eSpark-Backup/elliotrosenberg-oildiffuser/README.md

# Oil Diffuser Hardware Design
#### Client Name: Elliot Rosenberg

## Project Requirements
The project is essentially a hardware design for an Oil Diffuser product. Two variants of the design are required. The core features are highlighted below:
### Design Variant 01
- A circle with a maximum diameter of 5” with space on the inside for the atomizer disc. Placement should be followed as shown in image below
- The board should have 3 small holes for attachment to the body. See picture attached for clarification. Dia will be compatible with M2 screws.
- 24V input jack DC Barrel Input Jack.
- Circuit power controlled by a binary switch. ON should turn ON the following:
    - A small DC fan.
    - An ultrasonic atomizer and associated circuitry.
 
#### Reference Product Image


### Design Variant 02
- A circle with a maximum diameter of 4” with space on the inside for the atomizer disc.
- Rest of all requirements same as Variant 01.

### Additional Notes
- Original PRD pushed to docs folder
- Some reference links and resources are shared below as received:
    - [Ultrasonic Mist Maker](https://www.amazon.com/MEETOOT-2-Pack-Ultrasonic-Ceramics-Sealing/dp/B09L7KBF53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)
    - [Atomization Film Air Humidifier Driver Board](https://www.amazon.com/Atomization-Humidifier-Driver-Ultrasonic-Circuit/dp/B0BX6CV5P3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)
    - [ON/OFF Binary Switch](https://www.amazon.com/Gardner-Bender-GSW-18-Heavy-Duty-Electrical/dp/B00004WLKC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)
    - [DC Centrifugal Fan](https://www.amazon.com/Wathai-Brushless-Cooling-Turbo-Blower/dp/B07RP14KML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)
