eSpark-Backup/elliotrosenberg-oildiffuser/Design Files/Oil-Diffuser-A-v1.0.0/Deliverables/Renderings/3D-Bottom.png

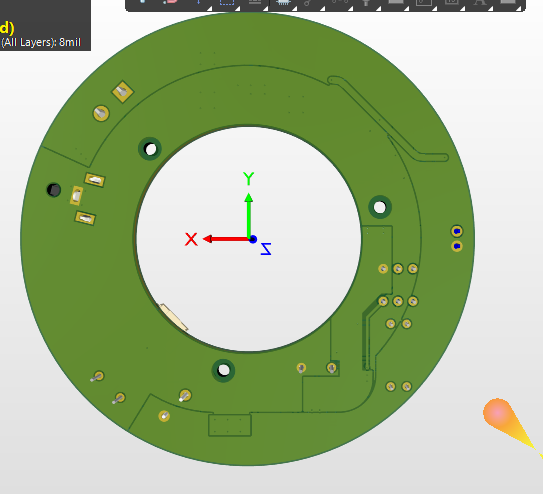
Design Files/Oil-Diffuser-A-v1.0.0/Deliverables/Renderings/3D-Bottom.png
