eSpark-Backup/elliotrosenberg-oildiffuser/Design Files/Oil-Diffuser-A-v1.0.0/BOM/Client-BOM-Oil-Diffuser-A-v1.0.0.xlsx

# | Item Type | Designator | Description | Footprint | Manufacturer Part Number | Manufacturer | Value | Quantity | Remarks
1 | Capacitors | C1 | 470uF 35V 850mA@100KHz 80mΩ@100KHz ±20% SMD,D8xL10.5mm Aluminum Electrolytic Capacitors - SMD ROHS | Custom | 189RV0027 | KNSCHA | 470uF | 1
2 | Capacitor | C2, C9 | 1uF 25V X5R ±20% 0603 Multilayer Ceramic Capacitors MLCC - SMD/SMT ROHS | Cap-0603 | TCC0603X5R105M250CT | CCTC | 1uF | 2
3 | Capacitors | C3 | 220uF 35V 600mA@100KHz 160mΩ@100KHz ±20% SMD,D6.3xL7.7mm Aluminum Electrolytic Capacitors - SMD ROHS | Custom | 189RV0019 | KNSCHA | 220uF | 1
4 | Capacitor | C4 | CAP CER 2.2UF 25V X5R 0603 | CAP-0603 | CC0603KRX5R8BB225 | Yageo | 2.2uF | 1
5 | Capacitor | C5 | 5% 630V 47nF Plugin,P=5.08mm Film Capacitors ROHS | Custom | CFA2J473JC4PK5136A00 | Dersonic | 47nF | 1
6 | Capacitor | C6 | CAP CER 100UF 16V X5R 1210 | Cap-1210 | EMK325ABJ107MM-P | Taiyo Yuden | 100uF | 1
7 | Capacitor | C7 | CAP CER 10000PF 50V X8R 0603 | Cap-0603 | GCM188R91H103KA37D | Murata | 10nF | 1
8 | Capacitors | C8 | ±5% 50V 220pF NP0 Plugin,P=5.08mm Multilayer Ceramic Capacitors MLCC - Leaded ROHS | Custom | CD1H221JC9BECHE100 | Dersonic | 220pF | 1
9 | Diode | D1, D2 | SCHOTTKY DIODE SMB 100V 5A | SMB_ | SS510B | MDD | - | 2
10 | Fuse | F1 | 33V 1.5A 40A 3A 1812 Resettable Fuses ROHS | Fuse-1812_ | BSMD1812-150-33V | BHFUSE | - | 1
11 | Terminal Blocks | J1 | TERM BLK 2P SIDE ENT 5.08MM PCB | Custom | 1715721 | Phoenix Contact | - | 1
12 | Wire To Board Connector | J2 | 1x2P 2P XH 1 Tin 2.5mm 2 -25℃~+85℃ Brass 3A Straight Plugin,P=2.5mm Wire To Board Connector ROHS | Custom | XH-2A-L | HCTL | - | 1
13 | DC Jack | J3 | DC Power Receptacle 260℃ Brass -20℃~+70℃ 2.5mm 6mm 2.5A 24V Plugin AC/DC Power Connectors ROHS | Custom | DC-0360-2.5 | XKB Connectivity | - | 1
14 | Right Angle JST | ~~J4~~ | ~~1x2P 1 2mm Male pin 2 -25℃~+85℃ 2A Surface Mount SMD,P=2mm Wire To Board / Wire To Wire Connector ROHS~~ | ~~Custom~~ | ~~WAFER-PH2.0-2PWB~~ | ~~XUNPU~~ | ~~DNP~~ | ~~1~~ | ~~DO NOT PLACE~~
15 | Inductor | L1 | 2A 68uH ±20% 2.5A SMD,6.6x7.1mm Power Inductors ROHS | Custom | PSPMAA0605H-680M-IGF | PROD Tech | 68uH | 1
16 | Inductor | L2 | 600mA 220uH EI-core Inductor ±20% Plugin Power Inductors ROHS | Custom | PK0810-221MB | SXN | 220uH | 1
17 | LED | LED1 | White light 0603 Light Emitting Diodes (LED) ROHS | LED-0603 | NCD0603W3 | Foshan NationStar Optoelectronics | - | 1
18 | Mosfet | Q1 | 30V 5.8A 32mΩ@10V,5.8A 1.4W 1.4V@250uA N Channel SOT-23 MOSFETs ROHS | sot-23 | AO3400A | BORN | - | 1
19 | BJTs | Q2, Q4 | TRANS NPN 40V 1A SOT23-3 | SOT-23 | ZXTN2040FTA | Diodes Zetex | - | 2
20 | MOSFETs | Q3 | 100V 15A 96W 114mΩ@10V,3A 3.5V@250uA 1 N-Channel TO-252 MOSFETs ROHS | TO-252-2L | STD12N10L-VB | VBsemi | - | 1
21 | Mosfet | Q5 | 30V 7A 19mΩ 1.9W 1.1V@250uA P Channel SOT-23-3L MOSFETs ROHS | SOT-23-3L_ | G7P03L | GoFord | - | 1
22 | Resistor | R1 | RES 1K OHM 1% 1/8W 0805 | RES-0805 | RC0805FR-071KL | Yageo | 1K | 1
23 | Resistors | R2 | RES SMD 1M OHM 1% 1/10W 0603 | Res-0603 | CRCW06031M00FKEA | Vishay | 1M | 1
24 | Resistors | R3 | Metal Film Resistors 1kΩ 250mW ±200ppm/℃ ±1% Plugin,D2.3xL6.5mm Through Hole Resistors ROHS | Plugin,D2.3xL6.5mm | MF1/4W-1KΩ±1%T52 | Huaxing Mechanical-Elec | 1K | 1
25 | Potentiometer | ~~R4, R10~~ | ~~10% 5kΩ Plugin Potentiometers, Variable Resistors ROHS~~ | ~~3296W-1-502~~ | ~~3296W-1-502~~ | ~~BOCHEN~~ | ~~DNP~~ | ~~2~~ | ~~DO NOT PLACE~~
26 | Resistor | R5 | RES 100K OHM 1% 1/8W 0805 | RES-0805 | RC0805FR-07100KL | Yageo | 100K | 1
27 | Resistors | R6 | RES 10 OHM 1% 3/4W 2010 | RES-2010 | RC2010FK-0710RL | Yageo | 10R | 1
28 | Resistor | R7 | RES 1K OHM 1% 1/2W 1206 | Res-1206 | RC1206FR-7W1KL | Yageo | 1K | 1
29 | Resistors | R8 | Metal Film Resistors 1.5kΩ 250mW ±100ppm/℃ ±1% Plugin,D2.3xL6.5mm Through Hole Resistors ROHS | Plugin,D2.3xL6.5mm | MF1/4W-1.5KΩ±1% T | CCO | 1.5K | 1
30 | Resistor | R9 | RES SMD 10K OHM 0.1% 1/10W 0603 | Res-0603 | RT0603BRD0710KL | Yageo | 10K | 1
31 |  | R11 | RES SMD 47OHM 0.1W 0603 | Res-0603 | RC0603FR-0747RL | Yageo | 47R | 1
32 | Resistor | R12, R14 | RES 1.5K OHM 1% 1/10W 0603 | Res-0603 | RC0603FR-071K5L | Yageo | 1.5K | 2
33 | Resistor | R13 | RES SMD 270 OHM 0.1% 1/10W 0603 | Res-0603 | RT0603BRE07270RL | Yageo | 270R | 1
34 | IC | U1 | Step-down type Fixed 12V 2A 4.5V~40V ESOP-8 DC-DC Converters ROHS | ESOP-8 | XL1509E-12 | UMW | - | 1
35 | IC | U2 | IC BINARY COUNTER 14-BIT 16SOIC | 16-SOIC (0.154", 3.90mm Width) | CD4060BM96 | Texas Instruments | - | 1
36 | IC | U3 | IC OSC SINGLE TIMER 2.7MHZ 8SOIC | SOIC-8(0.154", 3.90mm Width) | TS555IDTTR | STMicroelectronics | - | 1
37 | IC | U4 | IC GATE DRVR IGBT/MOSFET SOT23-6 | SOT-23-6 | ZXGD3002E6TA | Diodes Zetex | - | 1
38 | Peripheral | - | AC 110v 240V DC 24V 2A Power Supply wall charger Adapter US Charger | - | 24v 2 Amp US plug | - | - | 1 | Aliexpress (https://vi.aliexpress.com/item/1005003786598481.html)
39 | Peripheral | - | Toggle Switch | - | Toggle Switch | - | - | 1 | Aliexpress (https://vi.aliexpress.com/item/1005005545871582.html)
40 | Peripheral | - | 24V Sleeve XH2.54 | - | 24V Sleeve XH2.54 | - | - | 1 | Aliexpress (https://vi.aliexpress.com/item/1005002663971820.html)
41 | Peripheral | - | 16mm 1.7MHz | - | 16mm 1.7MHz | - | - | 1 | Aliexpress (https://vi.aliexpress.com/item/32848489683.html)
