eSpark-Backup/elliotrosenberg-oildiffuser/Design Files/Oil-Diffuser-A-v1.0.0/Deliverables/Supporting_Files/PCB-Oil Diffuser.step

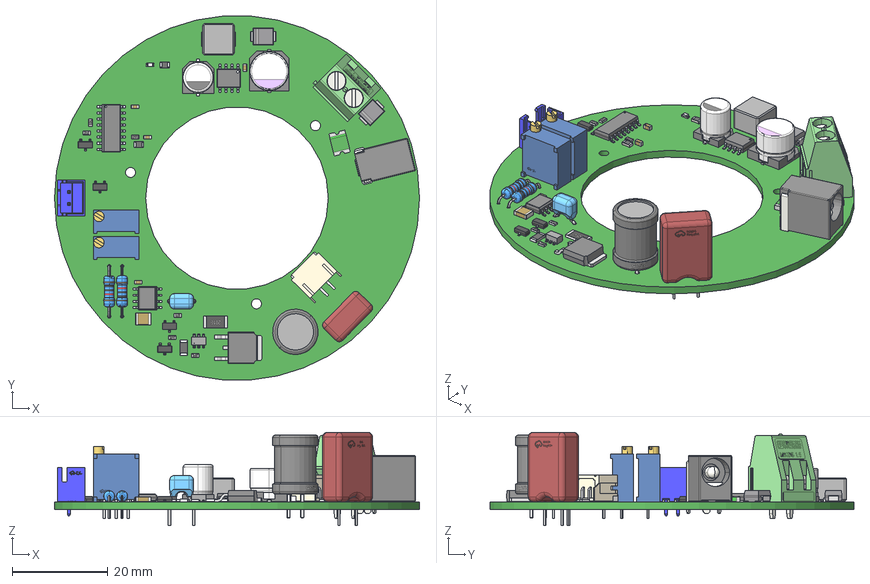
[picture p6: CAD file, 2024-11-26]
Design Files/Oil-Diffuser-A-v1.0.0/Deliverables/Supporting_Files/PCB-Oil Diffuser.step
76.2 x 76.0 x 19.5 mm
21-0058I_MXM
User Library-RESC1608X05N x 6
XUNPU WAFER-PH2.0-2PWB
PSPMAA0605H-680M-IGF
BODY-SO
LEAD-D0008A x 8
User Library-CR3216-1206
User Library-R_2010
CircuitWorks-SOT-23 x 4
User Library-DPAK-1
User Library-DO-214AA SMB x 2
User Library-CAPC1608X09 x 4
User Library-Fuse 1812
TP4056-42-ESOP8--3DModel-STEP-56544
User Library-CR2012-0805 x 2
MC14511BDG
User Library-LED SMD0603
COMPOUND.step
User Library-CAPC3225X10
