eSpark-Backup/elliotrosenberg-oildiffuser/(list of files, cad)

Other CAD files:
Design Files/Oil-Diffuser-A-v1.0.0/Deliverables/Supporting_Files/PCB-Oil Diffuser.DWG
Design Files/Oil-Diffuser-A-v1.0.0/Deliverables/Supporting_Files/PCB-Oil Diffuser.DXF
