eSpark-Backup/elliotrosenberg-oildiffuser/Design Files/Oil-Diffuser-A-v1.0.0/Oil-Diffuser-A-v1.0.0.pdf

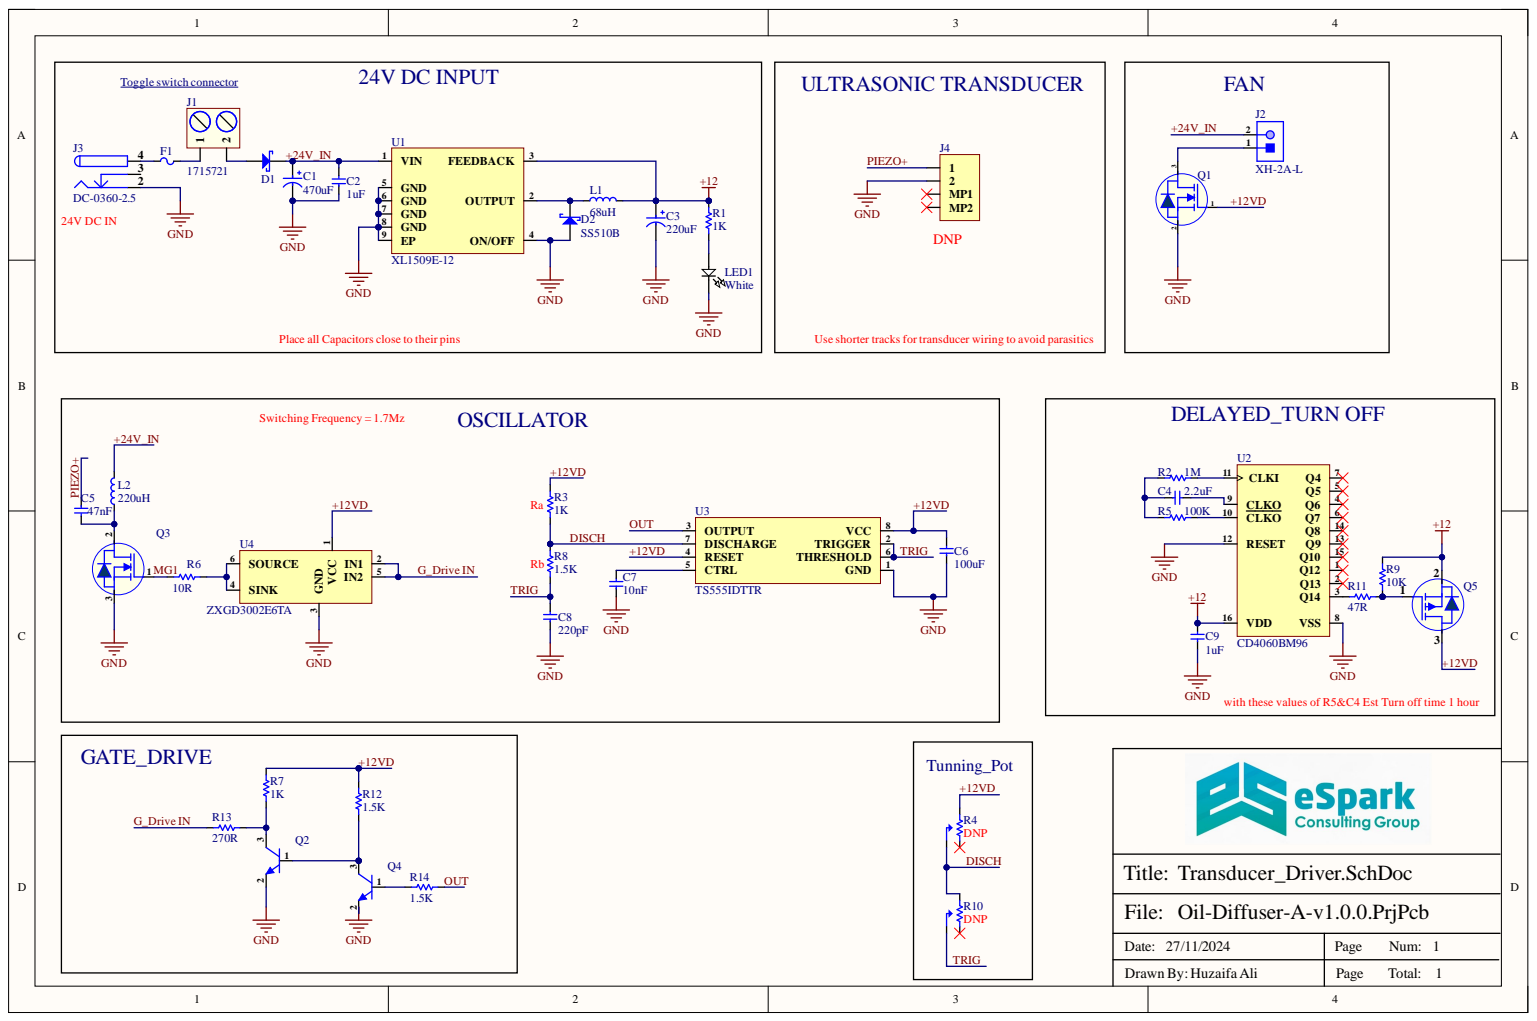
[picture p7: page 1]

Place all Capacitors close to their pins

with these values of R5&C4 Est Turn off time 1 hour
