eSpark-Backup/elliotrosenberg-oildiffuser/Design Files/Oil-Diffuser-A-v1.0.0/Deliverables/Assembly Drawing/Assembly_Drawing.pdf

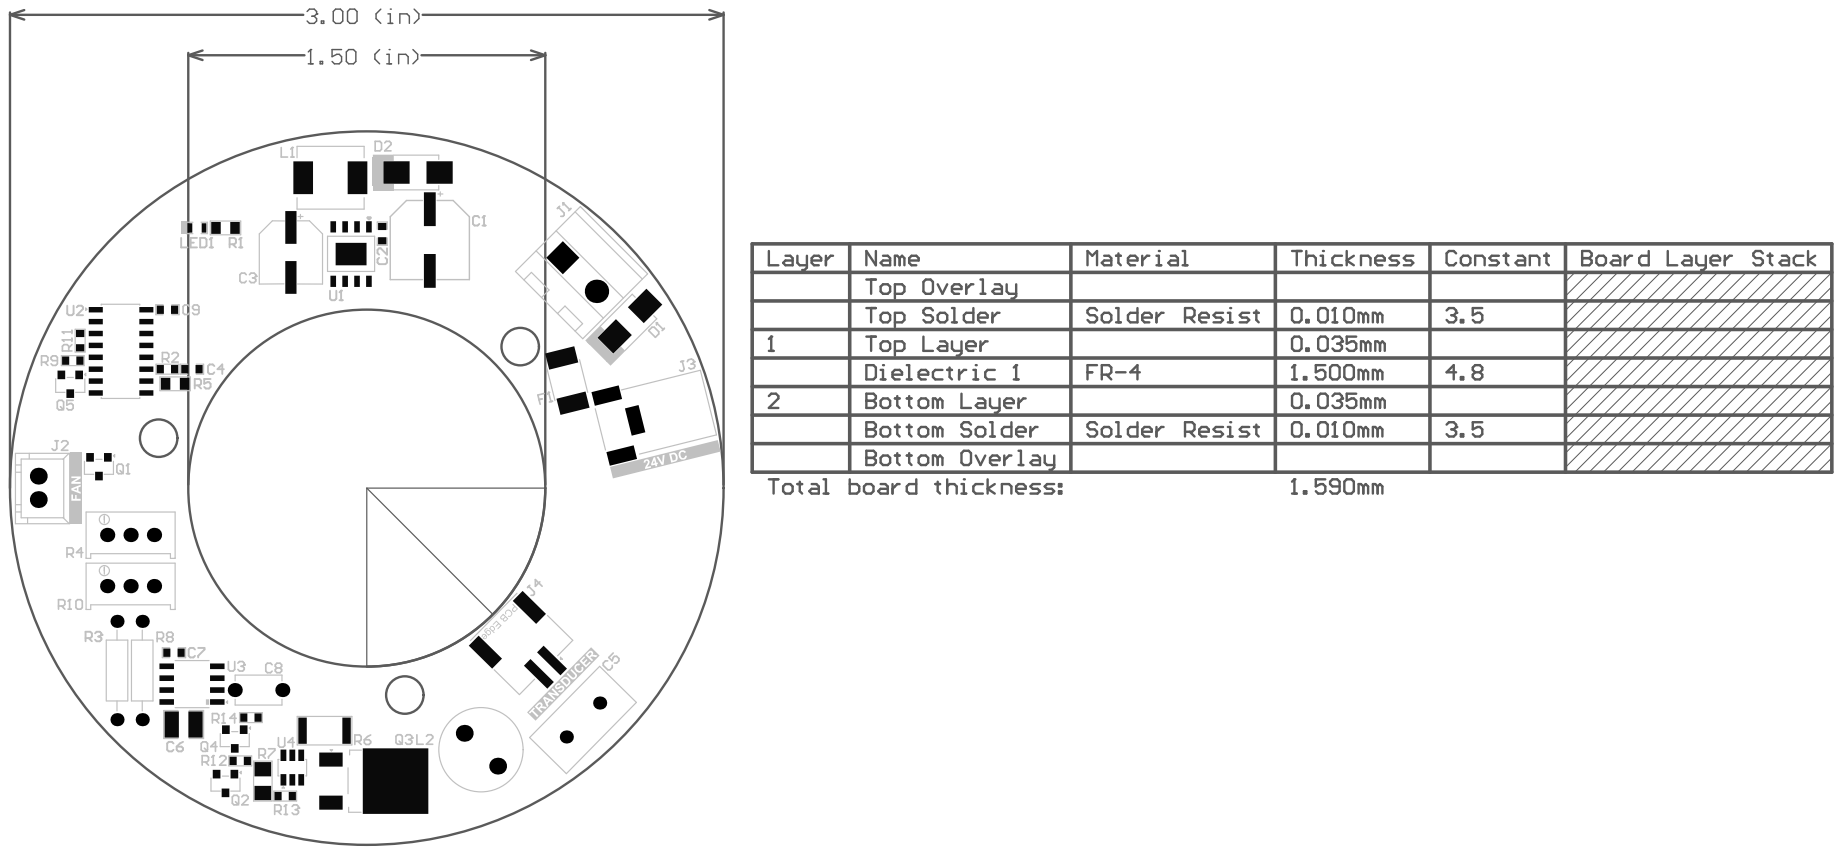
[picture p8: page 1]

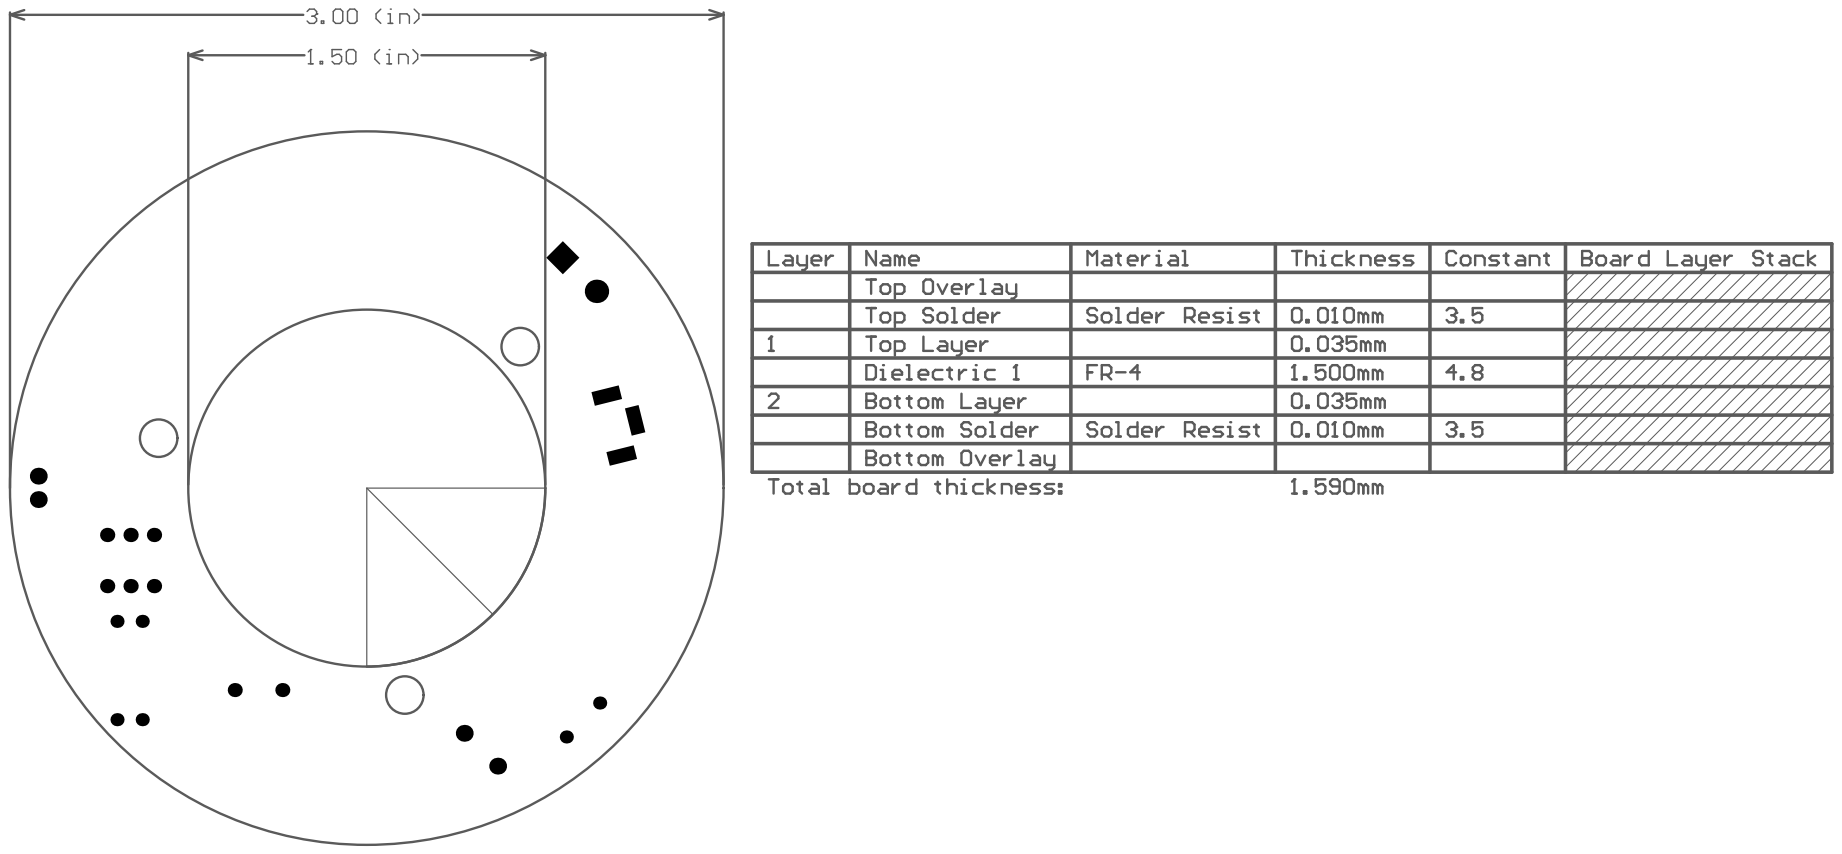
[picture p9: page 2]
