eSpark-Backup/elliotrosenberg-oildiffuser/(list of files, drawings)

Other design files:
Design Files/Oil-Diffuser-A-v1.0.0/Oil-Diffuser-A-v1.0.0.PrjPcb
Design Files/Oil-Diffuser-A-v1.0.0/PCB-Oil Diffuser.PcbDoc
Design Files/Oil-Diffuser-A-v1.0.0/Transducer_Driver.SchDoc
