eSpark-Backup/elliotrosenberg-oildiffuser/(commit log)

2024-10-24 #1 Added Connectors, oscilator circuit (Design changes in progress)
    [Oil-Diffuser-A-v1.0.0.PrjPcb, Power_Sheet.SchDoc]
2024-10-25 #1 Added Power switch, and updated transistor
    [Oil-Diffuser-A-v1.0.0.PrjPcb, Power_Sheet.SchDoc, Transducer_Driver.SchDoc]
2024-10-25 #1 net Label updated
    [Transducer_Driver.SchDoc]
2024-10-25 #1 updated capacitors, and resistors (preliminary design done)
    [Transducer_Driver.SchDoc]
2024-10-28 #1 PCB Component placement in progress
    [Oil-Diffuser-A-v1.0.0.PrjPcb, PCB1.PcbDoc, Transducer_Driver.SchDoc]
2024-10-30 #3 PCB Preliminary Component placement done for variant 01
    [PCB1.PcbDoc, Transducer_Driver.SchDoc]
2024-10-30 #3 minor placement changes done
    [PCB1.PcbDoc, Transducer_Driver.SchDoc]
2024-10-31 #3 Component placement updated (component routing in progress)
    [Oil-Diffuser-A-v1.0.0.PrjPcb, PCB-Oil Diffuser.PcbDoc, PCB1.PcbDoc]
2024-11-04 #3 routing in progress
    [PCB-Oil Diffuser.PcbDoc, Transducer_Driver.SchDoc]
2024-11-05 #3 Routing done
    [PCB-Oil Diffuser.PcbDoc, Transducer_Driver.SchDoc]
2024-11-05 #3 routing DRC errors mostly resolved
    [Oil-Diffuser-A-v1.0.0.PrjPcb, PCB-Oil Diffuser.PcbDoc, Transducer_Driver.SchDoc]
2024-11-05 #3 PCB design variant 01 routing done
    [PCB-Oil Diffuser.PcbDoc]
2024-11-06 #3 updated schematiic text
    [Transducer_Driver.SchDoc]
2024-11-06 #3 routing updated
    [PCB-Oil Diffuser.PcbDoc, Transducer_Driver.SchDoc]
2024-11-11 #6 eSpark BOM added.
    [eSpark-BOM-Oil-Diffuser-A-v1.0.0.xlsx]
2024-11-11 #6 Peripheral added.
    Toggle Switch Qty= 1
    [eSpark-BOM-Oil-Diffuser-A-v1.0.0.xlsx]
2024-11-11 #5 updated PCB as recomended in issue
    [PCB-Oil Diffuser.PcbDoc, Transducer_Driver.SchDoc]
2024-11-12 #6 Peripherals added.
    @mubbashirshirazi007
    SPST Toggle Switch
    24V Blower Fan
    24V 0.5A with US plug and DC barrel jack
    [eSpark-BOM-Oil-Diffuser-A-v1.0.0.xlsx]
2024-11-12 #1 Updated Capacitor C2 part number
    [PCB-Oil Diffuser.PcbDoc, Transducer_Driver.SchDoc]
2024-11-14 #6 C2 Change In BOM.
    [eSpark-BOM-Oil-Diffuser-A-v1.0.0.xlsx]
2024-11-15 #1 updated circuit with transistor based circuit
    [PCB-Oil Diffuser.PcbDoc, Transducer_Driver.SchDoc]
2024-11-19 #1 Updated High frequency generation scheme
    [Transducer_Driver.SchDoc]
2024-11-19 #1 Updated High frequency generation scheme (Design changes in progress)
    [Transducer_Driver.SchDoc]
2024-11-20 #1 updated high frequency generation section added delay turnoff section (design changes in progress)
    [Transducer_Driver.SchDoc]
2024-11-21 #1 Updated Schematic Design design
    [PCB-Oil Diffuser.PcbDoc, Transducer_Driver.SchDoc]
2024-11-22 #3 Placement in Progress
    [Oil-Diffuser-A-v1.0.0.PrjPcb, PCB-Oil Diffuser.PcbDoc]
2024-11-26 #3 Completed deliverables generated too
    [Centroid_file.csv, Client_BOM_Oil-Diffuser-A-v1.0.0.xlsx, Oil-Diffuser-A-v1.0.0.PrjPcb, PCB-Oil Diffuser.DWG, PCB-Oil Diffuser.DXF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]
2024-11-27 #7 Made Potentiometer (R4 and R10 ) DNP in schematic
    [Oil-Diffuser-A-v1.0.0.PrjPcb, Transducer_Driver.SchDoc]
2024-11-27 #1 Added DNP for connector J4 (Piezo Transducer Connector )
    [Transducer_Driver.SchDoc]
2024-11-27 #1 updated Schematic PDF (only)
2024-11-27 #6 eSpark and Client BOM updated.
    [Client-BOM-Oil-Diffuser-A-v1.0.0.xlsx, Client_BOM_Oil-Diffuser-A-v1.0.0.xlsx, eSpark-BOM-Oil-Diffuser-A-v1.0.0.xlsx]
2024-12-04 #8 JLCPCB BOM added.
    [JLCPCB-BOM-Oil-Diffuser-A-v1.0.0.xlsx]
2024-12-18 #7 User PCB testing guide (done)
2024-12-20 #7 Added links for peripheral in word DOC and PDF
    [Client-BOM-Oil-Diffuser-A-v1.0.0.xlsx]
